shimniok/eeZeeMicroSD/README.md

eeZeeMicroSD is a microSD breakout board that is pin-aligned with ATmega328P so you can just plug it into the breadboard without jumpers
