shimniok/eeZeeMicroSD/(list of files, cad)

Other CAD files:
electronics/eeZee_microSD.skp
