shimniok/eeZeeMicroSD/electronics/eeZee_microSD.brd

## EAGLE design electronics/eeZee_microSD.brd (2013-06-14)

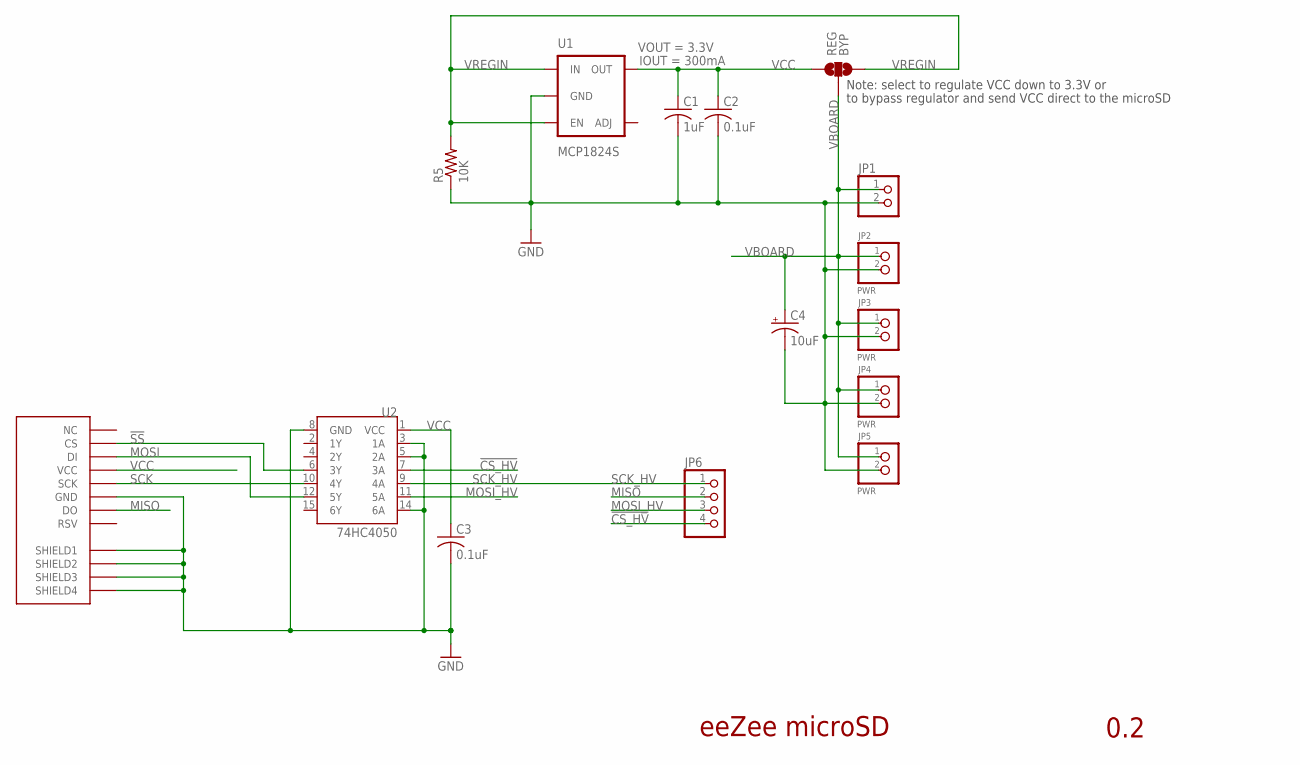
[picture p2: schematic eeZee_microSD.sch]

Parts:
C1: 1uF; C0603; PARTNO LMK107B7105KA-T
C2, C3: 0.1uF; C0603; PARTNO LMK107B7105KA-T
C4: 10uF; SMC_B; PARTNO LMK107B7105KA-T
JP1: PINHD-1X02_2.54-S; 1X02-S
JP2, JP3, JP4, JP5: PWR; BIGPIN-2
JP6: PINHD-1X04_2.54-S; 1X04-S
R5: 10K; R0603; PARTNO ERJ-3GEYJ103V
REG: BYP; SJ_3
U1: MCP1824S; SOT23-5; PARTNO MCP1824ST-3302E/DB
U2: 74HC4050; SO016
U$1: MICROSD_TFLASH; TFLASH_CP-0000-086

Connections:
!CS_HV: JP6.4, U2.7 (3A)
!SS: U2.6 (3Y), U$1.CS
GND: C1.2, C2.2, C3.2, C4.-, JP1.2, JP2.P$2 (2), JP3.P$2 (2), JP4.P$2 (2), JP5.P$2 (2), R5.1, U1.2 (GND), U2.3 (1A), U2.5 (2A), U2.8 (GND), U2.14 (6A), U$1.GND, U$1.SHIELD1, U$1.SHIELD2, U$1.SHIELD3, U$1.SHIELD4
MISO: JP6.2, U$1.DO
MOSI: U2.12 (5Y), U$1.DI
MOSI_HV: JP6.3, U2.11 (5A)
SCK: U2.10 (4Y), U$1.SCLK (SCK)
SCK_HV: JP6.1, U2.9 (4A)
VBOARD: C4.+, JP1.1, JP2.P$1 (1), JP3.P$1 (1), JP4.P$1 (1), JP5.P$1 (1), REG.2
VCC: C1.1, C2.1, C3.1, REG.1, U1.5 (OUT), U2.1 (VCC), U$1.VDD (VCC)
VREGIN: R5.2, REG.3, U1.1 (IN), U1.3 (EN)

Notes on the sheet:
Note: select to regulate VCC down to 3.3V or
to bypass regulator and send VCC direct to the microSD
eeZee microSD
0.2

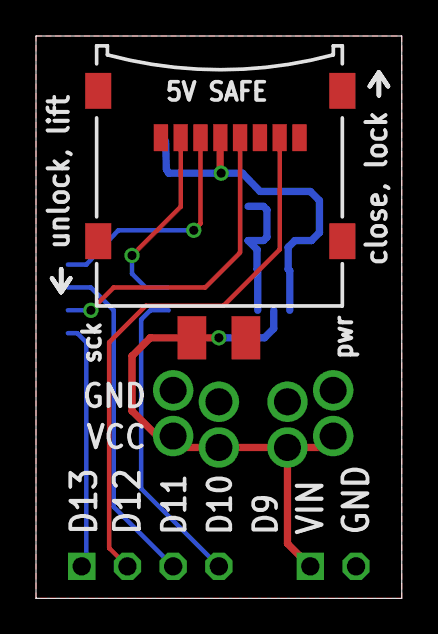
[picture p3: board eeZee_microSD.brd from above]

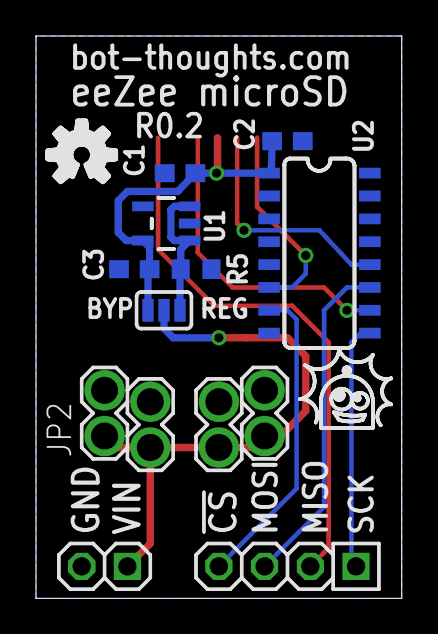
[picture p4: board eeZee_microSD.brd from below]

Board: 2 copper layers, 20.3 x 31.2 mm, 15 parts (13 on the bottom side), 11 nets.
