shimniok/eeZeeMicroSD/(commit log)

2012-12-13 Initial revision
    [eeZee microSD.brd, eeZee microSD.sch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]
2012-12-13 Added name/rev
    [eeZee microSD.sch]
2012-12-30 Added offset power strip header, tweaked layout, optimized 74HC4050 pin use, etc.
    [eeZee microSD.brd, eeZee microSD.sch]
2012-12-31 Minor tweaks/fixes.
    [eeZee microSD.brd, eeZee_microSD.skp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]
2013-02-04 Layout tweaks to fix power pin alignment.
    [eeZee microSD.brd, eeZee microSD.sch]
2013-06-14 Fixes to PropVGA, microSD,
    [eeZee microSD.brd, eeZee microSD.sch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]
2013-10-25 Renamed microSD files, moved to electronics subfolder
    [eeZee_microSD.brd, eeZee_microSD.sch, eeZee_microSD.skp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]
2013-10-25 Added Arduino example code / test
2015-12-15 updated instructions for D9/cd pin, and updated errata for solder jumper
